daveismith/charge-bay/W25Q16JVUXIQ_TR/USON-8_UX_2x3x0p6_WIN.step

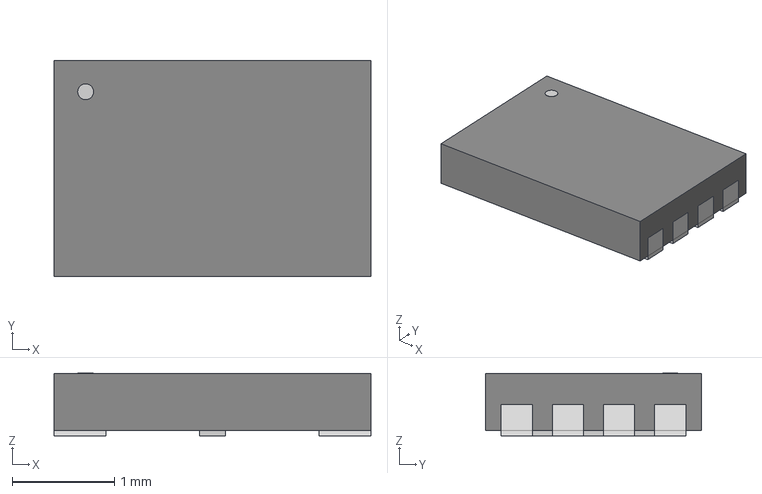
[picture p1: CAD file, 2025-01-03]
W25Q16JVUXIQ_TR/USON-8_UX_2x3x0p6_WIN.step
3.10 x 2.11 x 0.612 mm
