daveismith/charge-bay/charge_bay.kicad_pcb

## KiCad design charge_bay.kicad_pcb (2026-08-27)

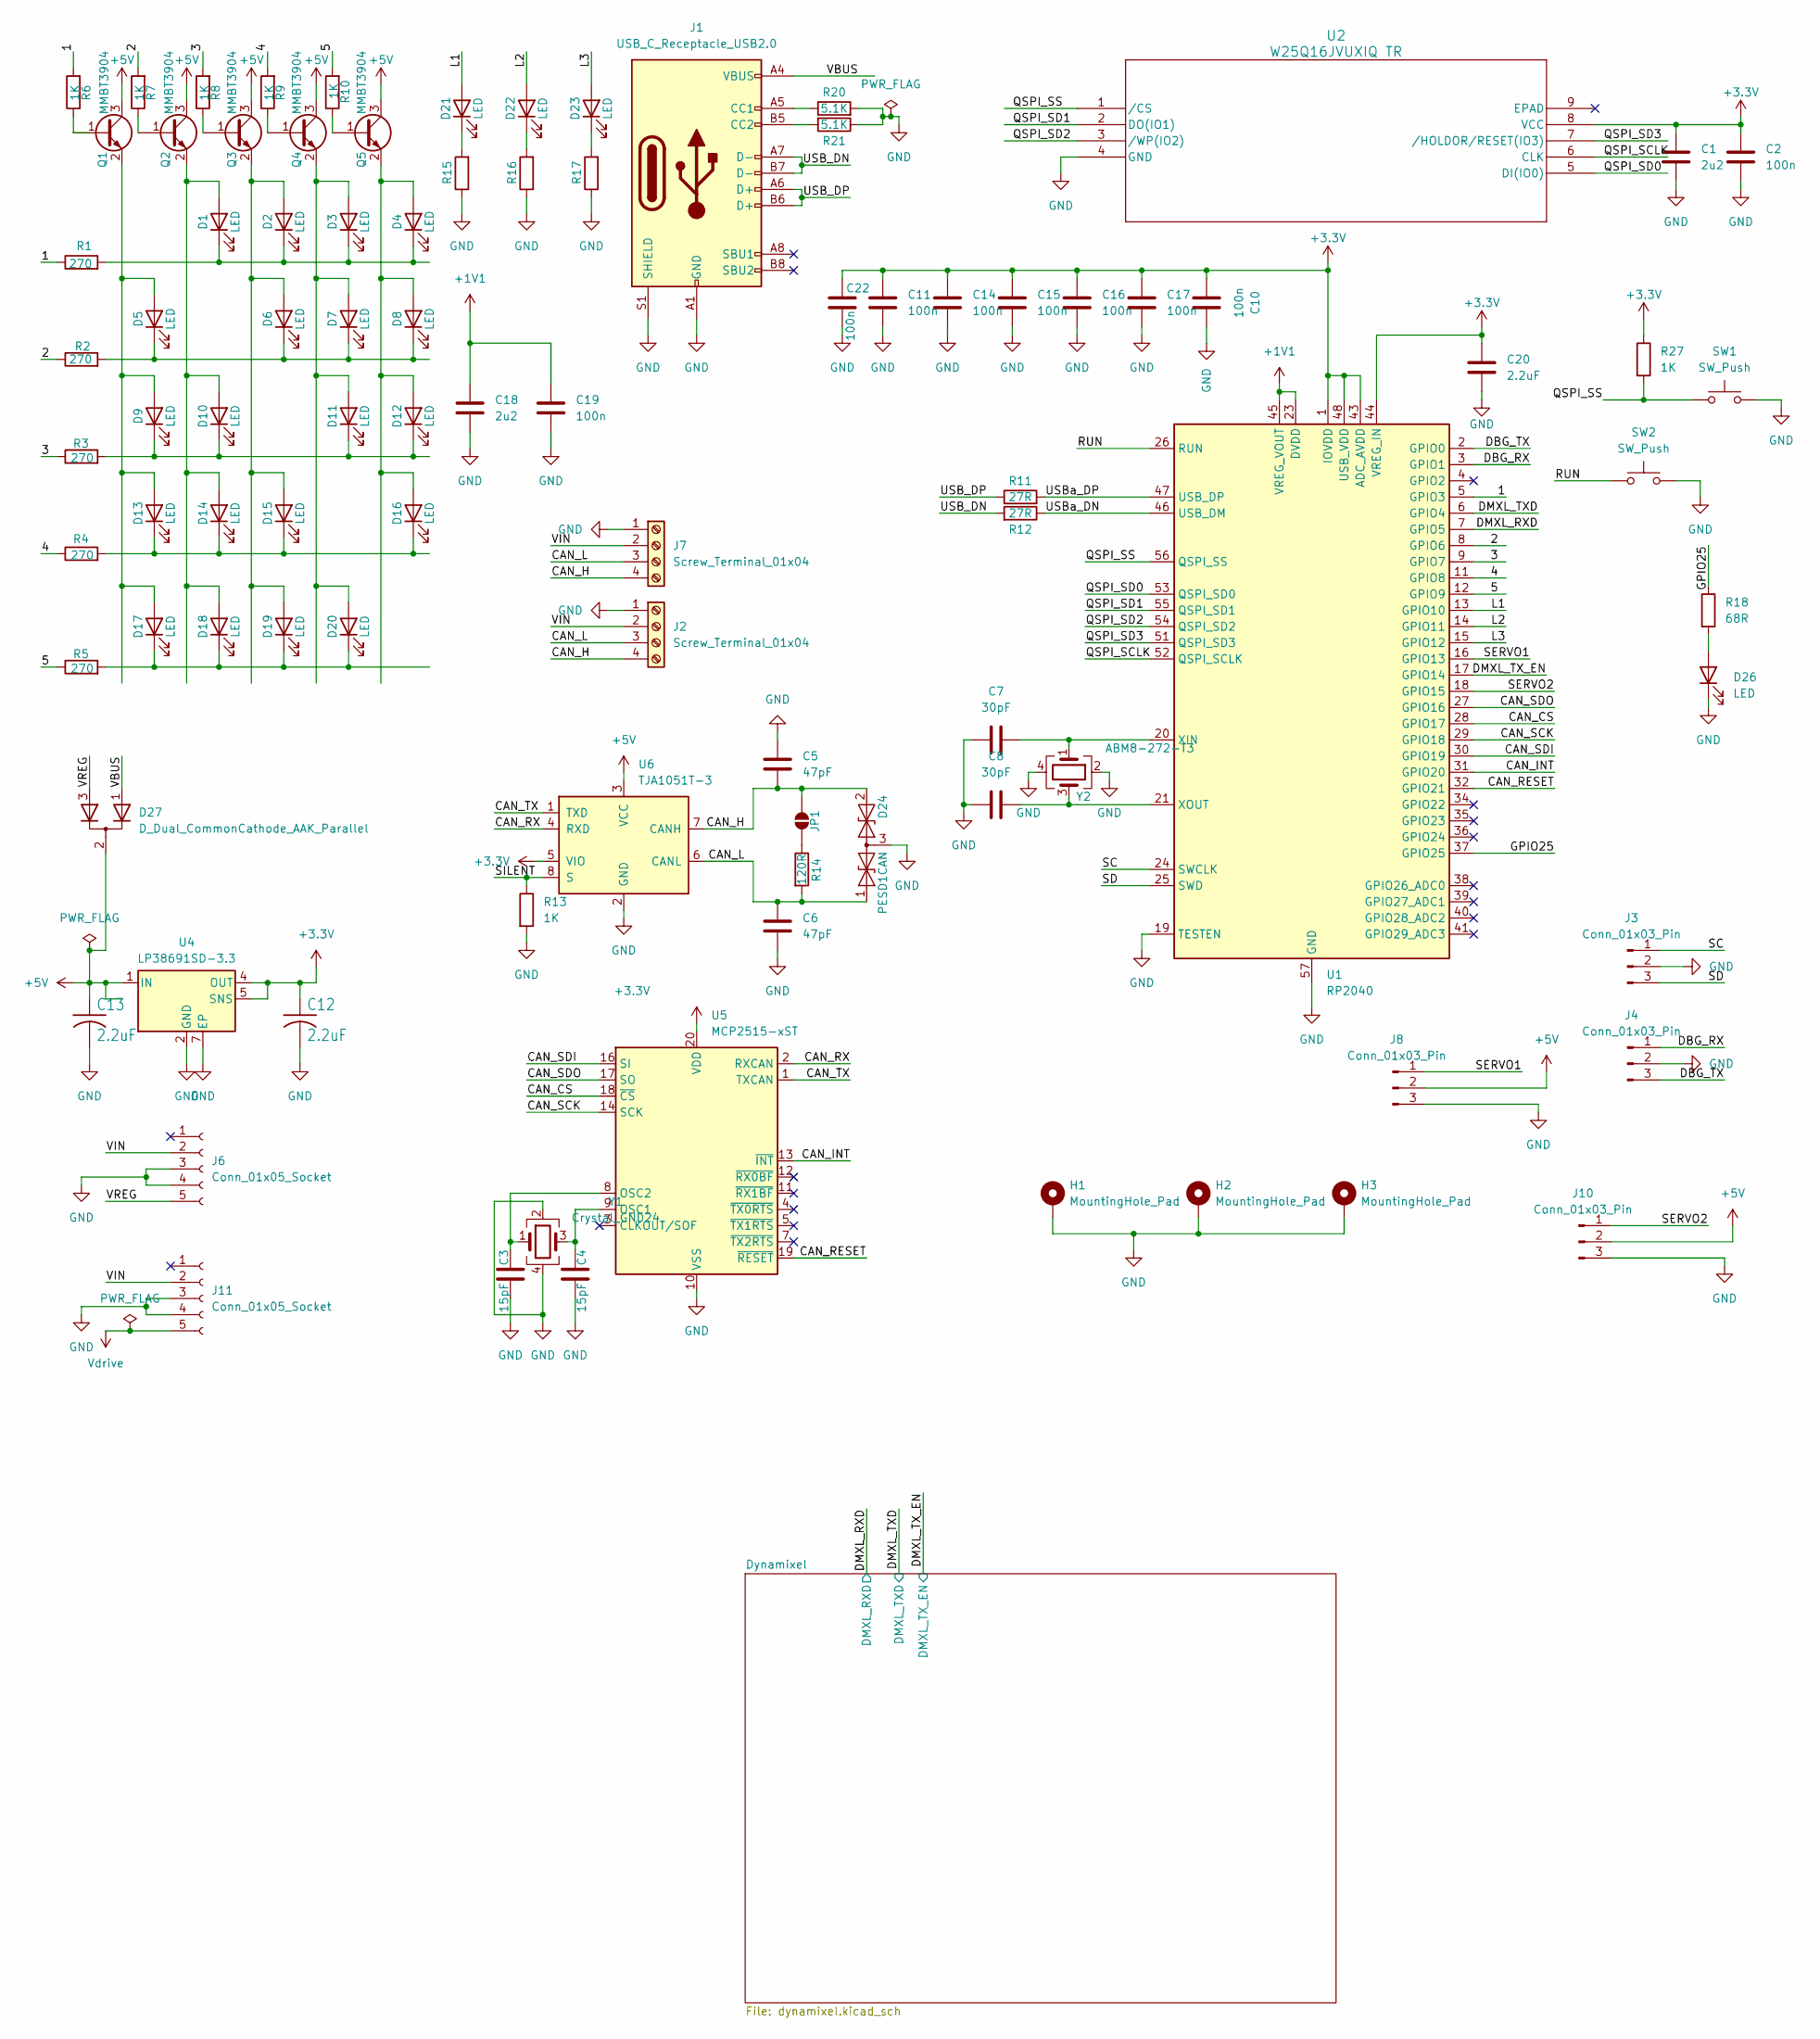
[picture p2: schematic charge_bay.kicad_sch]

Parts:
C1, C18: 2u2; C_0402_1005Metric; JLCPCB C12530
C2, C10, C11, C14, C15, C16, C17, C19, C22: 100n; C_0402_1005Metric; JLCPCB C1525
C3, C4: 15pF; C_0603_1608Metric; JLCPCB C1644
C5, C6: 47pF; C_0603_1608Metric; JLCPCB C1671
C7, C8: 30pF; C_0603_1608Metric; JLCPCB C1658
C12, C20: 2.2uF; C_0402_1005Metric; JLCPCB C12530
C13: 2.2uF; C_0603_1608Metric; JLCPCB C23630
D1, D2, D3, D4, D5, D6, D7, D8, D9, D10, D11, D12, D13, D14, D15, D16, D17, D18, D19, D20, D21, D22, D23: LED; LED_D3.0mm
D24: PESD1CAN; SOT-23; JLCPCB C284094
D26: LED; LED_0603_1608Metric; JLCPCB C2286
D27: D_Dual_CommonCathode_AAK_Parallel; SOT-223-3_TabPin2; JLCPCB C260229
H1, H2, H3: MountingHole_Pad; MountingHole_3.2mm_M3_DIN965_Pad_TopBottom
J1: USB_C_Receptacle_USB2.0; USB_C_Receptacle_G-Switch_GT-USB-7010ASV; JLCPCB C2988369
J2, J7: Screw_Terminal_01x04; TerminalBlock_Phoenix_PT-1,5-4-3.5-H_1x04_P3.50mm_Horizontal
J3, J4: Conn_01x03_Pin; JST_SH_BM03B-SRSS-TB_1x03-1MP_P1.00mm_Vertical
J6, J11: Conn_01x05_Socket; PinSocket_1x05_P2.54mm_Vertical
J8, J10: Conn_01x03_Pin; PinHeader_1x03_P2.54mm_Vertical
JP1: SolderJumper_2_Open; SolderJumper-2_P1.3mm_Open_TrianglePad1.0x1.5mm
Q1, Q2, Q3, Q4, Q5: MMBT3904; SOT-23; JLCPCB C20526
R1, R2, R3, R4, R5: 270; R_0603_1608Metric; JLCPCB C22966
R6, R7, R8, R9, R10, R13, R15, R16, R17, R27: 1K; R_0402_1005Metric; JLCPCB C11702
R11, R12: 27R; R_0402_1005Metric; JLCPCB C25100
R14: 120R; R_0402_1005Metric; JLCPCB C25079
R18: 68R; R_0402_1005Metric; JLCPCB C25131
R20, R21: 5.1K; R_0402_1005Metric; JLCPCB C25905
SW1, SW2: SW_Push; SW_Push_1P1T_XKB_TS-1187A; JLCPCB C318884
U1: RP2040; QFN-56-1EP_7x7mm_P0.4mm_EP3.2x3.2mm; JLCPCB C2040
U2: W25Q16JVUXIQ TR; USON-8_UX_2x3x0p6_WIN; JLCPCB C2843335
U4: LP38691SD-3.3; WSON-6-1EP_3x3mm_P0.95mm; JLCPCB C2876186
U5: MCP2515-xST; TSSOP-20_4.4x6.5mm_P0.65mm; JLCPCB C15193
U6: TJA1051T-3; SOIC-8_3.9x4.9mm_P1.27mm; JLCPCB C38695
Y1: Crystal_GND24; Crystal_SMD_Abracon_ABM8G-4Pin_3.2x2.5mm; JLCPCB C13738
Y2: ABM8-272-T3; Crystal_SMD_Abracon_ABM8G-4Pin_3.2x2.5mm; JLCPCB C9002

Connections:
+1V1: C18.1, C19.1, U1.23 (DVDD), U1.45 (VREG_VOUT), U1.50 (DVDD)
+3.3V: C1.1, C2.1, C10.1, C11.2, C12.1, C14.2, C15.2, C16.2, C17.2, C20.1, C22.2, R27.1, U1.1 (IOVDD), U1.10 (IOVDD), U1.22 (IOVDD), U1.33 (IOVDD), U1.42 (IOVDD), U1.43 (ADC_AVDD), U1.44 (VREG_IN), U1.48 (USB_VDD), U1.49 (IOVDD), U2.8 (VCC), U4.4 (OUT), U4.5 (SNS), U5.20 (VDD), U6.5 (VIO); also elsewhere on the board
+5V: C13.1, D27.2 (K), J8.2, J10.2, Q1.3 (C), Q2.3 (C), Q3.3 (C), Q4.3 (C), Q5.3 (C), U4.1 (IN), U4.6 (IN), U6.3 (VCC); also elsewhere on the board
/1: R1.1, R6.2, U1.5 (GPIO3)
/2: R2.1, R7.2, U1.8 (GPIO6)
/3: R3.1, R8.2, U1.9 (GPIO7)
/4: R4.1, R9.2, U1.11 (GPIO8)
/5: R5.1, R10.2, U1.12 (GPIO9)
/CAN_CS: U1.28 (GPIO17), U5.18 (~CS)
/CAN_H: C5.2, D24.2 (A2), J2.4, J7.4, JP1.2 (B), U6.7 (CANH)
/CAN_INT: U1.31 (GPIO20), U5.13 (~INT)
/CAN_L: C6.1, D24.1 (A1), J2.3, J7.3, R14.2, U6.6 (CANL)
/CAN_RESET: U1.32 (GPIO21), U5.19 (~RESET)
/CAN_RX: U5.2 (RXCAN), U6.4 (RXD)
/CAN_SCK: U1.29 (GPIO18), U5.14 (SCK)
/CAN_SDI: U1.30 (GPIO19), U5.16 (SI)
/CAN_SDO: U1.27 (GPIO16), U5.17 (SO)
/CAN_TX: U5.1 (TXCAN), U6.1 (TXD)
/DBG_RX: J4.1, U1.3 (GPIO1)
/DBG_TX: J4.3, U1.2 (GPIO0)
/DMXL_RXD: U1.7 (GPIO5); also elsewhere on the board
/DMXL_TXD: U1.6 (GPIO4); also elsewhere on the board
/DMXL_TX_EN: U1.17 (GPIO14); also elsewhere on the board
/GPIO25: R18.1, U1.37 (GPIO25)
/L1: D21.2 (A), U1.13 (GPIO10)
/L2: D22.2 (A), U1.14 (GPIO11)
/L3: D23.2 (A), U1.15 (GPIO12)
/QSPI_SCLK: U1.52 (QSPI_SCLK), U2.6 (CLK)
/QSPI_SD0: U1.53 (QSPI_SD0), U2.5 (DI(IO0))
/QSPI_SD1: U1.55 (QSPI_SD1), U2.2 (DO(IO1))
/QSPI_SD2: U1.54 (QSPI_SD2), U2.3 (/WP(IO2))
/QSPI_SD3: U1.51 (QSPI_SD3), U2.7 (/HOLDOR/RESET(IO3))
/QSPI_SS: R27.2, SW1.1, U1.56 (QSPI_SS), U2.1 (/CS)
/RUN: SW2.1, U1.26 (RUN)
/SC: J3.1, U1.24 (SWCLK)
/SD: J3.3, U1.25 (SWD)
/SERVO1: J8.1, U1.16 (GPIO13)
/SERVO2: J10.1, U1.18 (GPIO15)
/SILENT: R13.1, U6.8 (S)
/USB_DN: J1.A7 (D-), J1.B7 (D-), R12.2
/USB_DP: J1.A6 (D+), J1.B6 (D+), R11.1
/USBa_DN: R12.1, U1.46 (USB_DM)
/USBa_DP: R11.2, U1.47 (USB_DP)
/VBUS: D27.1 (A), J1.A4 (VBUS), J1.A9 (VBUS), J1.B4 (VBUS), J1.B9 (VBUS)
/VIN: J2.2, J6.2, J7.2, J11.2
/VREG: D27.3 (A), J6.5
GND: C1.2, C2.2, C3.2, C4.2, C5.1, C6.2, C7.1, C8.1, C10.2, C11.1, C12.2, C13.2, C14.1, C15.1, C16.1, C17.1, C18.2, C19.2, C20.2, C22.1, D24.3 (common), D26.1 (K), H1.1, H2.1, H3.1, J1.A1 (GND), J1.A12 (GND), J1.B1 (GND), J1.B12 (GND), J1.S1 (SHIELD), J2.1, J3.2, J4.2, J6.3, J6.4, J7.1, J8.3, J10.3, J11.3, J11.4, R13.2, R15.1, R16.1, R17.1, R20.2, R21.1, SW1.2, SW2.2, U1.19 (TESTEN), U1.57 (GND), U2.4 (GND), U4.2 (GND), U4.7 (EP), U5.10 (VSS), U6.2 (GND), Y1.2, Y1.4, Y2.2, Y2.4; also elsewhere on the board
unnamed: D1.2 (A), D10.2 (A), D14.2 (A), D18.2 (A), Q2.2 (E)
unnamed: D1.1 (K), D2.1 (K), D3.1 (K), D4.1 (K), R1.2
unnamed: D5.1 (K), D6.1 (K), D7.1 (K), D8.1 (K), R2.2
unnamed: D9.1 (K), D10.1 (K), D11.1 (K), D12.1 (K), R3.2
unnamed: D3.2 (A), D7.2 (A), D11.2 (A), D20.2 (A), Q4.2 (E)
unnamed: D4.2 (A), D8.2 (A), D12.2 (A), D16.2 (A), Q5.2 (E)
unnamed: D5.2 (A), D9.2 (A), D13.2 (A), D17.2 (A), Q1.2 (E)
unnamed: D13.1 (K), D14.1 (K), D15.1 (K), D16.1 (K), R4.2
unnamed: D2.2 (A), D6.2 (A), D15.2 (A), D19.2 (A), Q3.2 (E)
unnamed: D17.1 (K), D18.1 (K), D19.1 (K), D20.1 (K), R5.2
unnamed: D21.1 (K), R15.2
unnamed: D22.1 (K), R16.2
unnamed: D23.1 (K), R17.2
unnamed: D26.2 (A), R18.2
unnamed: J1.A5 (CC1), R20.1
unnamed: J1.B5 (CC2), R21.2
unnamed: JP1.1 (A), R14.1
unnamed: Q1.1 (B), R6.1
unnamed: Q2.1 (B), R7.1
unnamed: Q3.1 (B), R8.1
unnamed: Q4.1 (B), R9.1
unnamed: Q5.1 (B), R10.1
unnamed: C7.2, U1.20 (XIN), Y2.1
unnamed: C8.2, U1.21 (XOUT), Y2.3
unnamed: C4.1, U5.9 (OSC1), Y1.3
unnamed: C3.1, U5.8 (OSC2), Y1.1
Vdrive: J11.5; also elsewhere on the board

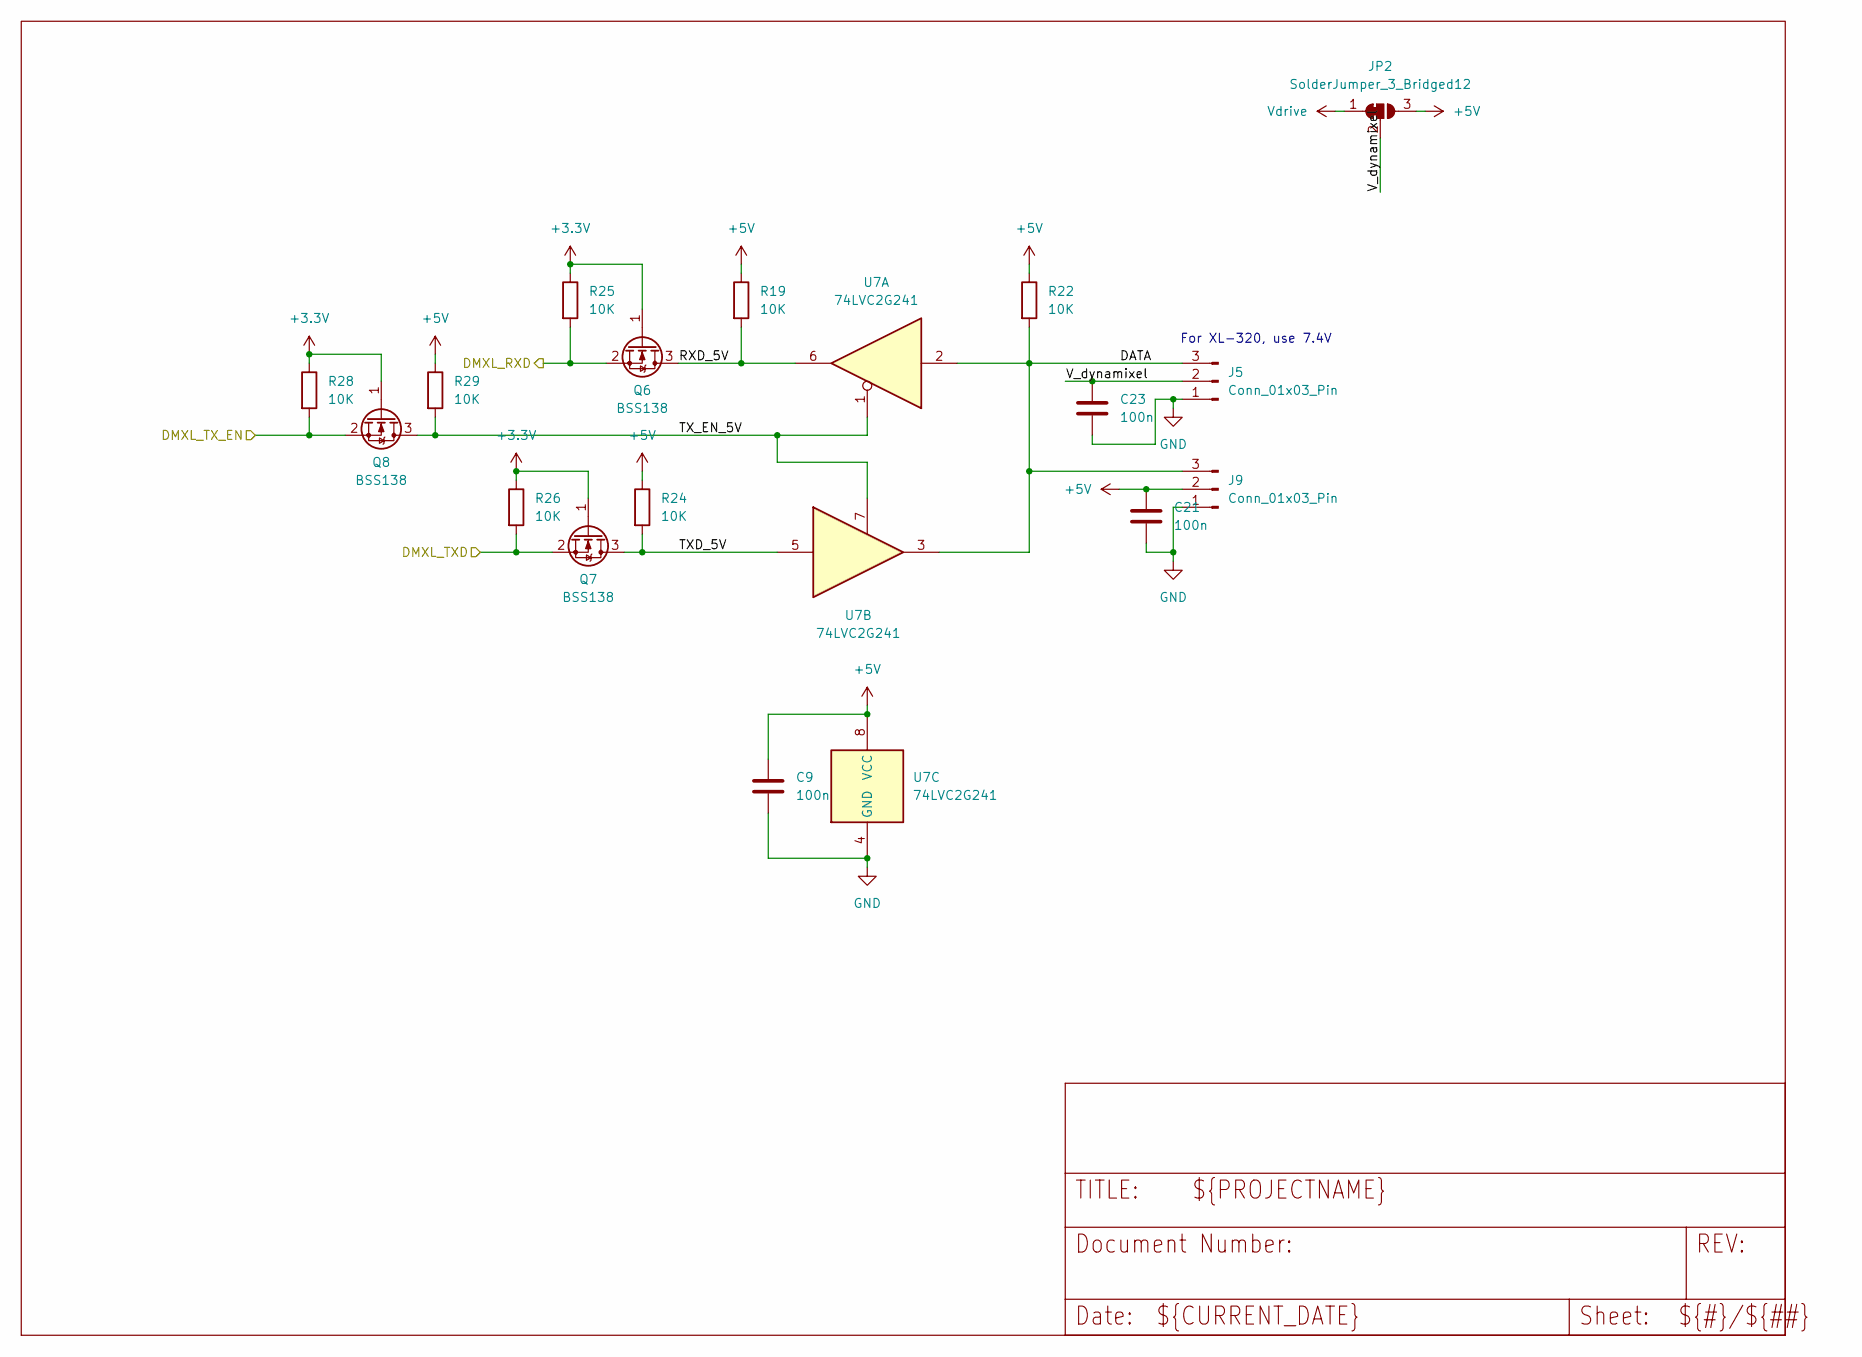
[picture p3: schematic dynamixel.kicad_sch]

Parts:
C9, C21, C23: 100n; C_0603_1608Metric; JLCPCB C14663
J5: Conn_01x03_Pin; Molex_Micro-Latch_53253-0370_1x03_P2.00mm_Vertical
J9: Conn_01x03_Pin; JST_EH_B3B-EH-A_1x03_P2.50mm_Vertical
JP2: SolderJumper_3_Bridged12; SolderJumper-3_P1.3mm_Bridged12_RoundedPad1.0x1.5mm
Q6, Q7, Q8: BSS138; SOT-23; JLCPCB C78284
R19, R22, R24, R25, R26, R28, R29: 10K; R_0402_1005Metric; JLCPCB C25744
U7: 74LVC2G241; VSSOP-8_2.3x2mm_P0.5mm; JLCPCB C10430

Connections:
+3.3V: Q6.1 (G), Q7.1 (G), Q8.1 (G), R25.1, R26.1, R28.1; also elsewhere on the board
+5V: C9.1, C21.1, J9.2, JP2.3 (B), R19.1, R22.1, R24.1, R29.1, U7.8 (VCC); also elsewhere on the board
/DMXL_RXD: Q6.2 (S), R25.2; also elsewhere on the board
/DMXL_TXD: Q7.2 (S), R26.2; also elsewhere on the board
/DMXL_TX_EN: Q8.2 (S), R28.2; also elsewhere on the board
/Dynamixel/DATA: J5.3, J9.3, R22.2, U7.2, U7.3
/Dynamixel/RXD_5V: Q6.3 (D), R19.2, U7.6
/Dynamixel/TXD_5V: Q7.3 (D), R24.2, U7.5
/Dynamixel/TX_EN_5V: Q8.3 (D), R29.2, U7.1, U7.7
/Dynamixel/V_dynamixel: C23.1, J5.2, JP2.2 (C)
GND: C9.2, C21.2, C23.2, J5.1, J9.1, U7.4 (GND); also elsewhere on the board
Vdrive: JP2.1 (A); also elsewhere on the board

Notes on the sheet:
For XL-320, use 7.4V

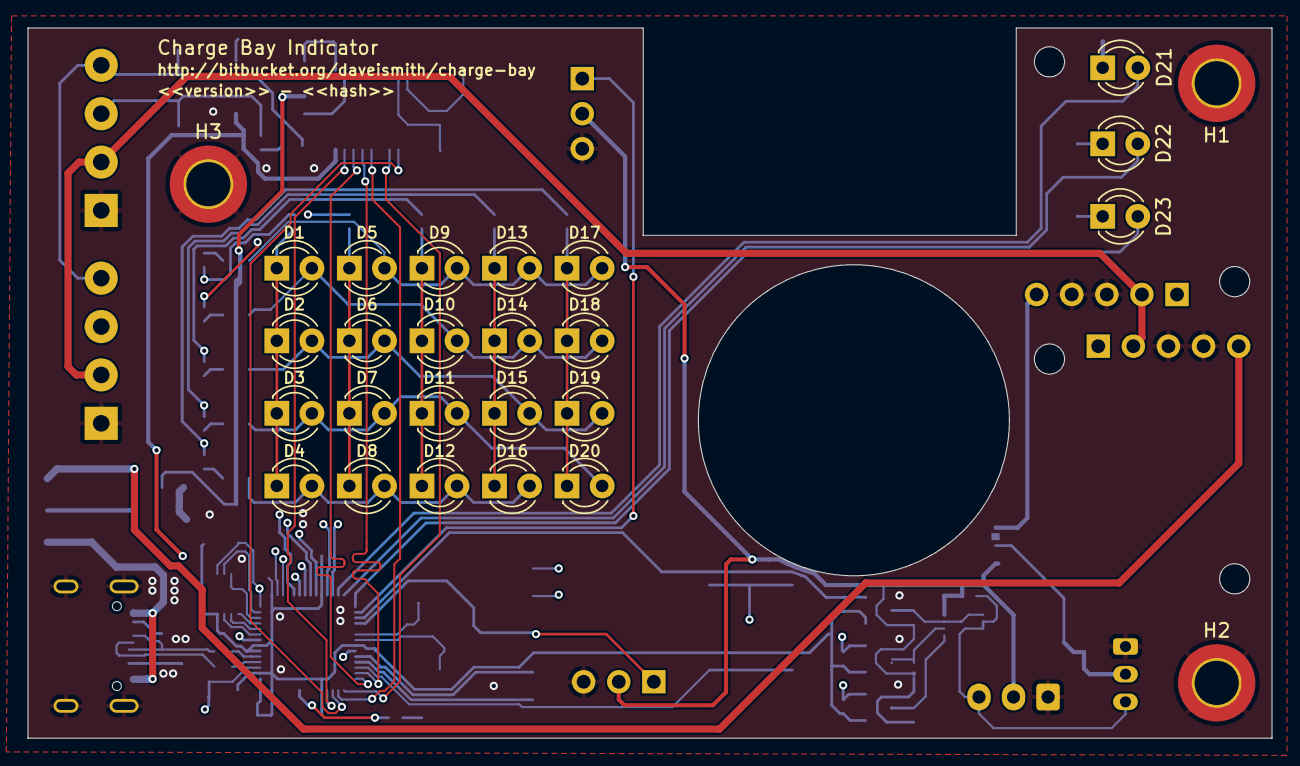
[picture p4: board charge_bay.kicad_pcb from above]

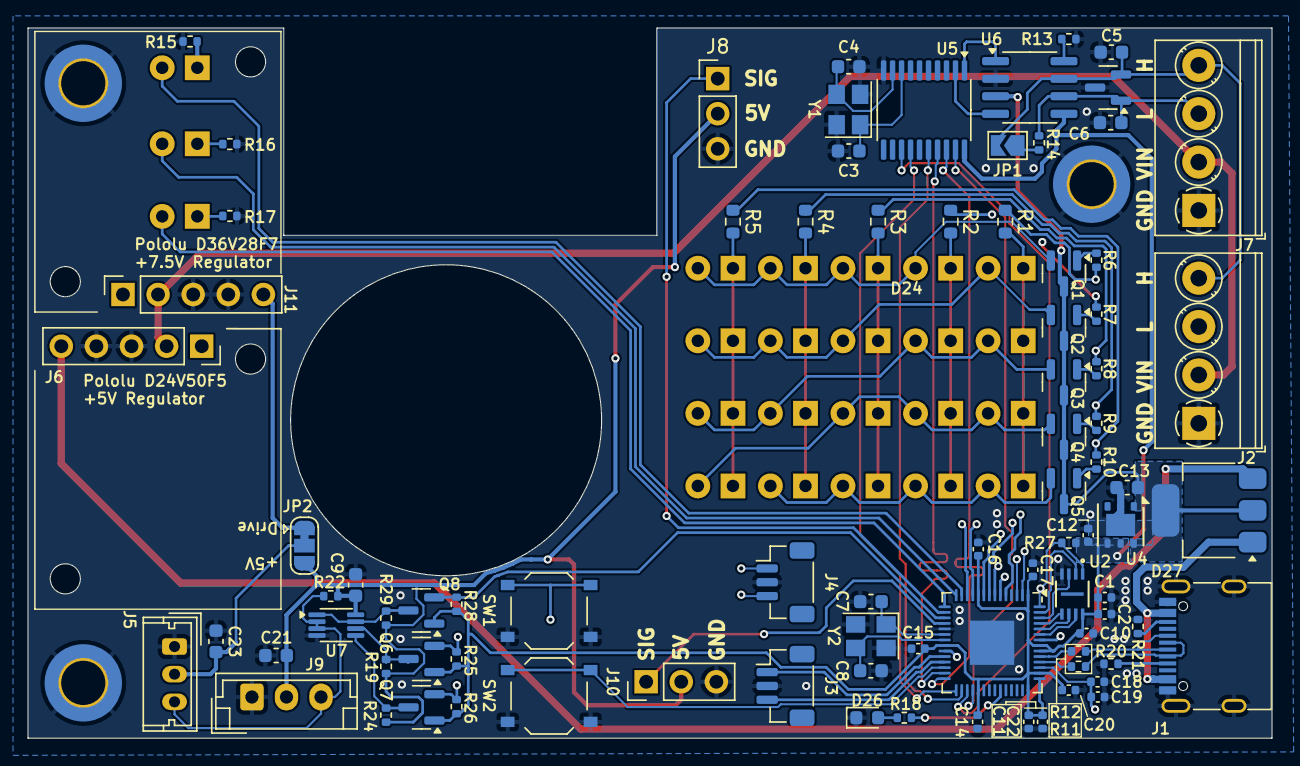
[picture p5: board charge_bay.kicad_pcb from below]

Board: 4 copper layers, 90.0 x 51.4 mm, 111 parts (85 on the bottom side), 79 nets.
