daveismith/charge-bay/(commit log)

2025-01-04 Update to swap to basic for MMBT3904 transistors
    [charge_bay.kicad_sch]
2025-01-04 Adjustments for Generation
    [charge_bay.kicad_pcb]
2025-01-04 Adds Regulator & adjusts rotation on Y2, D24, U1, U2 & U5
    [charge_bay.kicad_sch]
2025-01-04 Update Silkscreen With Pololu Parts
    [charge_bay.kicad_pcb]
2025-01-05 Update Silkscreen With Pololu Parts, etc.
    [charge_bay.kicad_pcb, charge_bay.kicad_sch]
2025-01-05 Fixing 10K Part Number
    [dynamixel.kicad_sch]
2026-08-27 Feature/release upload (#1)
    * Adding Release Artifact Capability
    * Update to KiCad 9
    * Further Release Process Updates
    - try to fix component warnings by syncing to schematic
    - add auto version updates to PCB tagging
    - adjust the URL on the board to point to the correct repo.
    [charge_bay.kicad_pcb, charge_bay.kicad_sch, dynamixel.kicad_sch]
2026-08-27 Compress Gerbers before Artifact & Release Upload
